disdi/10BaseT1S-PMOD/kicad/output_files/BOM-step0.csv

References | Value | MPN | Manufacturer | Footprint | Description | Quantity | DNP
C1 | 100n |  |  | Capacitor_SMD:C_0402_1005Metric | Oscillator local decoupling, 100 nF, 0402. | 1
C2 | 100n |  |  | Capacitor_SMD:C_0402_1005Metric | +3V3 decoupling at the PMOD, 100 nF, 0402. | 1
C3 | 10u |  |  | Capacitor_SMD:C_0805_2012Metric | VDDP bulk, 10 µF, 0805, X5R. Device side of FB1. | 1
C4 | 100n |  |  | Capacitor_SMD:C_0402_1005Metric | VDDP pin 8, 100 nF, 0402. | 1
C5 | 10n |  |  | Capacitor_SMD:C_0402_1005Metric | VDDP pin 8, 10 nF, closest to the pin, 0402. | 1
C6 | 100n |  |  | Capacitor_SMD:C_0402_1005Metric | VDDP pin 18, 100 nF, 0402. | 1
C7 | 10n |  |  | Capacitor_SMD:C_0402_1005Metric | VDDP pin 18, 10 nF, closest to the pin, 0402. | 1
C8 | 10u |  |  | Capacitor_SMD:C_0805_2012Metric | VDDA bulk, 10 µF, 0805, X5R. Device side of FB2. | 1
C9 | 100n |  |  | Capacitor_SMD:C_0402_1005Metric | VDDA pin 29, 100 nF, 0402. | 1
C10 | 10n |  |  | Capacitor_SMD:C_0402_1005Metric | VDDA pin 29, 10 nF, closest to the pin, 0402. | 1
C11 | 10n |  |  | Capacitor_SMD:C_0402_1005Metric | VDDAU pin 25, 10 nF, 0402. VDDAU is tied to VDDA. | 1
C12 | 100n |  |  | Capacitor_SMD:C_0402_1005Metric | VDDAU pin 25, 100 nF, 0402. | 1
C13 | 100n 100V | 885012207128 |  | Capacitor_SMD:C_0805_2012Metric | Cable-side coupling, 100 nF, 100 V, 0805, on TRXP. | 1
C14 | 100n 100V | 885012207128 |  | Capacitor_SMD:C_0805_2012Metric | Cable-side coupling, 100 nF, 100 V, 0805, on TRXN. | 1
C15 | 100n 100V | 885012207128 |  | Capacitor_SMD:C_0805_2012Metric | Termination common-mode capacitor, 100 nF, 100 V, 0805. | 1
D1 | ESD | EZA-EG3W11AV |  | Diode_SMD:D_0603_1608Metric | Bidirectional ESD suppressor, TRX_P to GND. | 1
D2 | ESD | EZA-EG3W11AV |  | Diode_SMD:D_0603_1608Metric | Bidirectional ESD suppressor, TRX_N to GND. | 1
FB1 | FB | 742792640 |  | Resistor_SMD:R_0805_2012Metric | VDDP ferrite, 300 ohm at 100 MHz. | 1
FB2 | FB | 742792640 |  | Resistor_SMD:R_0805_2012Metric | VDDA and VDDAU ferrite, 300 ohm at 100 MHz. | 1
J1 | PMOD |  |  | pmod-conn_6x2:pmod_pin_array_6x2 | Arty A7 JB pinout: pin 1 CLK50 output, pin 10 TXD0 input. NOT Katze/LiteX pin compatible. | 1
J2 | SPE | 691102710002 |  | TerminalBlock_Phoenix:TerminalBlock_Phoenix_MKDS-1,5-2_1x02_P5.00mm_Horizontal | 2-pin 5.00 mm screw terminal. Pin 1 TRX_P, pin 2 TRX_N. | 1
J3 | MDIO |  |  | Connector_PinHeader_2.54mm:PinHeader_1x03_P2.54mm_Vertical | MDIO header. Pin 1 MDC, pin 2 MDIO, pin 3 GND. Required for PLCA. | 1
JP1 | END | 62000211121 |  | Connector_PinHeader_2.00mm:PinHeader_1x02_P2.00mm_Vertical | Fit both JP1 and JP2 for an end-node 100 ohm termination. Leave both open for a drop node. | 1
JP2 | END | 62000211121 |  | Connector_PinHeader_2.00mm:PinHeader_1x02_P2.00mm_Vertical | Fit both JP1 and JP2 for an end-node 100 ohm termination. Leave both open for a drop node. | 1
L1 | ACT1210D | ACT1210D-131-2P-TL00 |  | ACT1210:ACT1210D | Common-mode choke. Windings 1-4 (TRXN) and 2-3 (TRXP). No polarity. | 1
R1 | 1.5k |  |  | Resistor_SMD:R_0402_1005Metric | MDIO pull-up, 1.5 kΩ to VDDP. | 1
R2 | 12.4k 1% | ERJP03F1242V |  | Resistor_SMD:R_0603_1608Metric | RBIAS, 12.4 kΩ 1% to GND. | 1
R3 | 10k |  |  | Resistor_SMD:R_0402_1005Metric | MODE1 pull-up. RMII is MODE[1:0]=10. | 1
R4 | 10k |  |  | Resistor_SMD:R_0402_1005Metric | MODE0 pull-down. RMII is MODE[1:0]=10. | 1
R5 | 10k |  |  | Resistor_SMD:R_0402_1005Metric | PHYAD0 pull-down. Address bit 0, pin 21 RXER. | 1
R6 | 10k |  |  | Resistor_SMD:R_0402_1005Metric | PHYAD4 pull-down. Address bit 4, pin 15 CRS. | 1
R7 | 10k |  |  | Resistor_SMD:R_0402_1005Metric | PHYAD1 pull-down on CRSDV. Address bit 1. | 1
R8 | 10k |  |  | Resistor_SMD:R_0402_1005Metric | PHYAD2 pull-down on RXD0. Address bit 2. | 1
R9 | 10k |  |  | Resistor_SMD:R_0402_1005Metric | PHYAD3 pull-down on RXD1. Address bit 3. | 1
R10 | 10k |  |  | Resistor_SMD:R_0402_1005Metric | TXEN pull-down. Required while the MAC pin is Hi-Z. | 1
R11 | 10k |  |  | Resistor_SMD:R_0402_1005Metric | WAKE_IN pull-down, pin 32. | 1
R12 | 10k |  |  | Resistor_SMD:R_0402_1005Metric | RESET_N pull-up to VDDP. PMOD pin 9 also drives it. | 1
R13 | 10k |  |  | Resistor_SMD:R_0402_1005Metric | IRQ_N pull-up to VDDP. Not brought to the PMOD. | 1
R14 | 10k |  |  | Resistor_SMD:R_0402_1005Metric | GPIO0 pull-down. | 1
R15 | 0 | ERJ-2GE0R00X |  | Resistor_SMD:R_0402_1005Metric | Series 0 ohm on TRXP, PHY side of the CMC. | 1
R16 | 0 | ERJ-2GE0R00X |  | Resistor_SMD:R_0402_1005Metric | Series 0 ohm on TRXN, PHY side of the CMC. | 1
R17 | 49.9 1% | ERJP03F49R9V |  | Resistor_SMD:R_0603_1608Metric | End-node termination, 49.9 Ω 1%. | 1
R18 | 49.9 1% | ERJP03F49R9V |  | Resistor_SMD:R_0603_1608Metric | End-node termination, 49.9 Ω 1%. | 1
R19 | 100k |  |  | Resistor_SMD:R_0603_1608Metric | Termination bleed, 100 kΩ to GND. | 1
R20 | 33 |  |  | Resistor_SMD:R_0402_1005Metric | 33 ohm clock source termination; tune by signal-integrity measurement. | 1
R21 | 33 |  |  | Resistor_SMD:R_0402_1005Metric | 33 ohm clock source termination; tune by signal-integrity measurement. | 1
U1 | LAN8670 | LAN8670C2T-E/LMX |  | Package_DFN_QFN:QFN-32-1EP_5x5mm_P0.5mm_EP3.45x3.45mm | LAN8670 RMII. MODE[1:0]=10. PHY address 0. Exposed pad is pin 33, VSS. | 1
U2 | 50MHz | KC2520Z50.0000C1KX00 | KYOCERA AVX | Oscillator:Oscillator_SMD_Kyocera_KC2520Z-4Pin_2.5x2.0mm | KYOCERA AVX KC2520Z50.0000C1KX00. 3.3 V, 50 MHz, ±20 ppm, -40 to +85 C. Output enable (pin 1) tied high. Drives REFCLKIN and Arty JB pin 1 through separate 33 ohm resistors. | 1
