disdi/10BaseT1S-PMOD/kicad/step0.kicad_pcb

## KiCad design kicad/step0.kicad_pcb (2026-10-29)

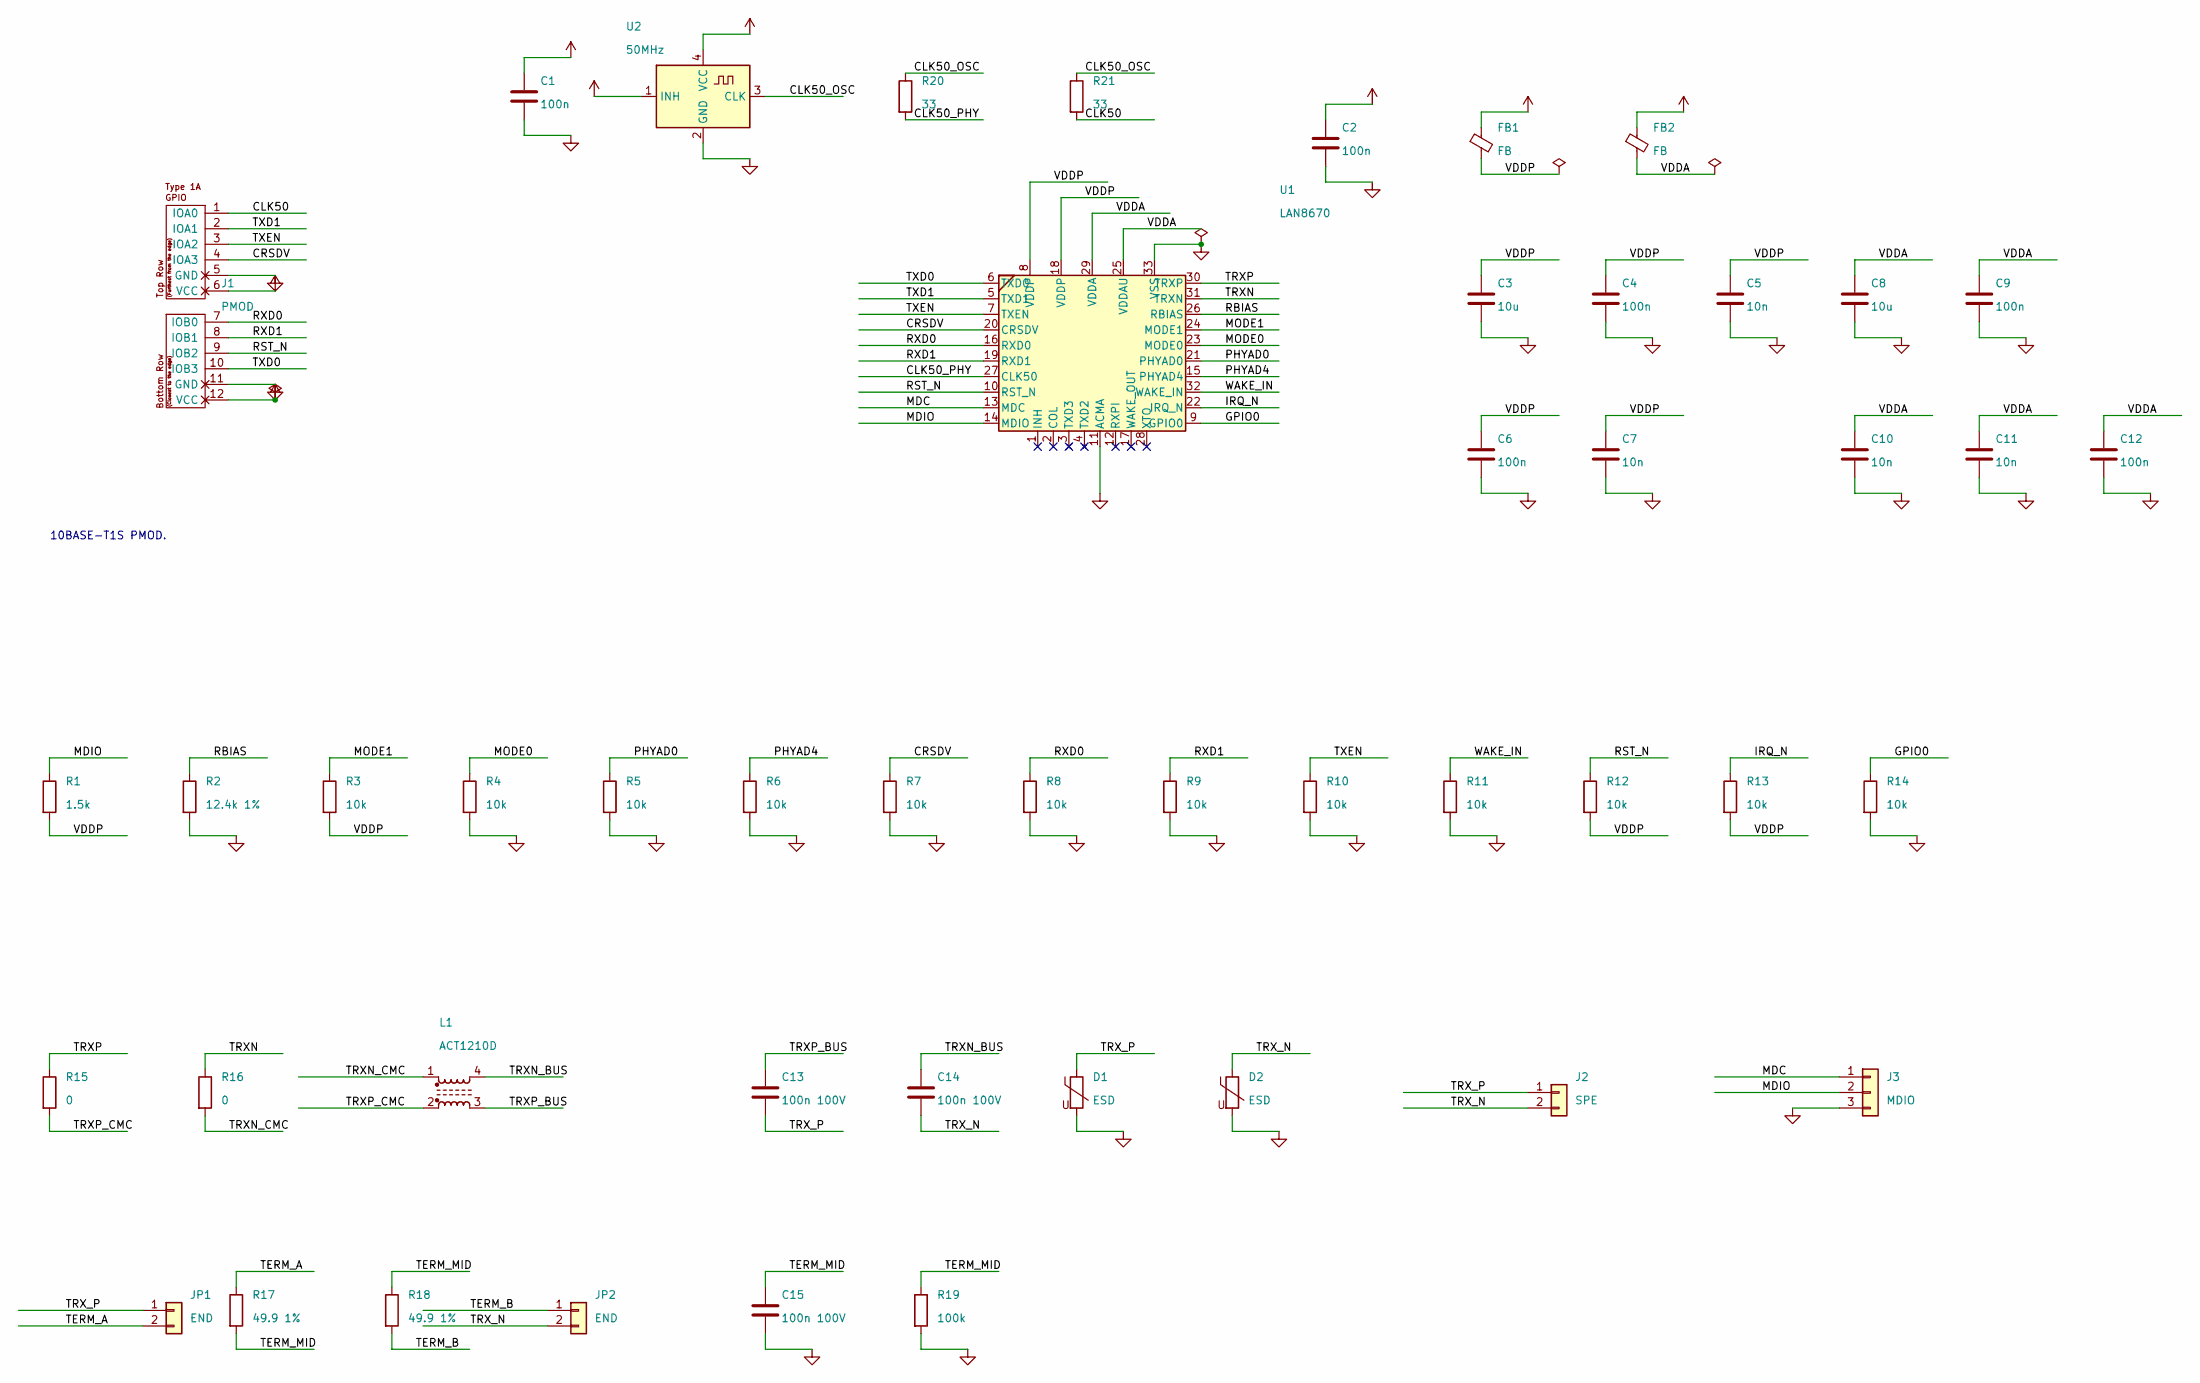
[picture p1: schematic step0.kicad_sch, 10BASE-T1S PMOD - Arty A7 JB]

Parts:
C1, C2, C4, C6, C9, C12: 100n; C_0402_1005Metric
C3, C8: 10u; C_0805_2012Metric
C5, C7, C10, C11: 10n; C_0402_1005Metric
C13, C14, C15: 100n 100V; C_0805_2012Metric; MPN 885012207128
D1, D2: ESD; D_0603_1608Metric; MPN EZA-EG3W11AV
FB1, FB2: FB; R_0805_2012Metric; MPN 742792640
J1: PMOD; pmod_pin_array_6x2
J2: SPE; TerminalBlock_Phoenix_MKDS-1,5-2_1x02_P5.00mm_Horizontal; MPN 691102710002
J3: MDIO; PinHeader_1x03_P2.54mm_Vertical
JP1, JP2: END; PinHeader_1x02_P2.00mm_Vertical; MPN 62000211121
L1: ACT1210D; MPN ACT1210D-131-2P-TL00
R1: 1.5k; R_0402_1005Metric
R2: 12.4k 1%; R_0603_1608Metric; MPN ERJP03F1242V
R3, R4, R5, R6, R7, R8, R9, R10, R11, R12, R13, R14: 10k; R_0402_1005Metric
R15, R16: 0; R_0402_1005Metric; MPN ERJ-2GE0R00X
R17, R18: 49.9 1%; R_0603_1608Metric; MPN ERJP03F49R9V
R19: 100k; R_0603_1608Metric
R20, R21: 33; R_0402_1005Metric
U1: LAN8670; QFN-32-1EP_5x5mm_P0.5mm_EP3.45x3.45mm; MPN LAN8670C2T-E/LMX
U2: 50MHz; Oscillator_SMD_Kyocera_KC2520Z-4Pin_2.5x2.0mm; MPN KC2520Z50.0000C1KX00

Connections:
+3V3: C1.1, C2.1, FB1.1, FB2.1, J1.6 (VCC), J1.12 (VCC), U2.1 (INH), U2.4 (VCC)
/CLK50: J1.1 (IOA0), R21.2
/CLK50_OSC: R20.1, R21.1, U2.3 (CLK)
/CLK50_PHY: R20.2, U1.27 (CLK50)
/CRSDV: J1.4 (IOA3), R7.1, U1.20 (CRSDV)
/GPIO0: R14.1, U1.9 (GPIO0)
/IRQ_N: R13.1, U1.22 (IRQ_N)
/MDC: J3.1, U1.13 (MDC)
/MDIO: J3.2, R1.1, U1.14 (MDIO)
/MODE0: R4.1, U1.23 (MODE0)
/MODE1: R3.1, U1.24 (MODE1)
/PHYAD0: R5.1, U1.21 (PHYAD0)
/PHYAD4: R6.1, U1.15 (PHYAD4)
/RBIAS: R2.1, U1.26 (RBIAS)
/RST_N: J1.9 (IOB2), R12.1, U1.10 (RST_N)
/RXD0: J1.7 (IOB0), R8.1, U1.16 (RXD0)
/RXD1: J1.8 (IOB1), R9.1, U1.19 (RXD1)
/TERM_A: JP1.2, R17.1
/TERM_B: JP2.1, R18.2
/TERM_MID: C15.1, R17.2, R18.1, R19.1
/TRXN: R16.1, U1.31 (TRXN)
/TRXN_BUS: C14.1, L1.4
/TRXN_CMC: L1.1, R16.2
/TRXP: R15.1, U1.30 (TRXP)
/TRXP_BUS: C13.1, L1.3
/TRXP_CMC: L1.2, R15.2
/TRX_N: C14.2, D2.1, J2.2, JP2.2
/TRX_P: C13.2, D1.1, J2.1, JP1.1
/TXD0: J1.10 (IOB3), U1.6 (TXD0)
/TXD1: J1.2 (IOA1), U1.5 (TXD1)
/TXEN: J1.3 (IOA2), R10.1, U1.7 (TXEN)
/WAKE_IN: R11.1, U1.32 (WAKE_IN)
GND: C1.2, C2.2, C3.2, C4.2, C5.2, C6.2, C7.2, C8.2, C9.2, C10.2, C11.2, C12.2, C15.2, D1.2, D2.2, J1.5 (GND), J1.11 (GND), J3.3, R2.2, R4.2, R5.2, R6.2, R7.2, R8.2, R9.2, R10.2, R11.2, R14.2, R19.2, U1.11 (ACMA), U1.33 (VSS), U2.2 (GND)

Notes on the sheet:
10BASE-T1S PMOD.

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
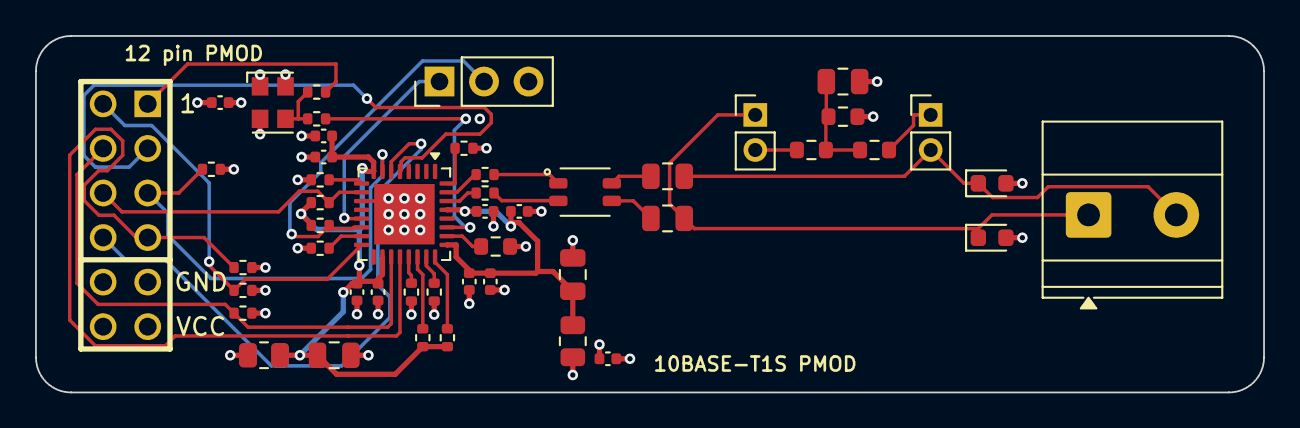
[picture p2: board step0.kicad_pcb from above]

Board: 4 copper layers, 70.0 x 20.3 mm, 48 parts (0 on the bottom side), 35 nets.
