disdi/10BaseT1S-PMOD/(commit log)

2026-10-29 Add KiCad 9 10BASE-T1S PMOD revision 0.2
    Publish the LAN8670 RMII PMOD sources for Arty A7 JB: schematic, PCB,
    project, local libraries, BOM, pick-and-place, and gerbers. README
    documents the pinout, circuit, and remaining engineering hold.
2026-10-29 Document the MIT LICENSE in the file table
    README now lists LICENSE with the KiCad sources, BOM, CPL and gerbers.
